Mastene-CHAOUCHE/asservissement-num-rique-d-un-oscillateur-quartz/README.md

# asservissement-num-rique-d-un-oscillateur-quartz
