Mastene-CHAOUCHE/asservissement-num-rique-d-un-oscillateur-quartz/exterior-Case/PCB.FCStd

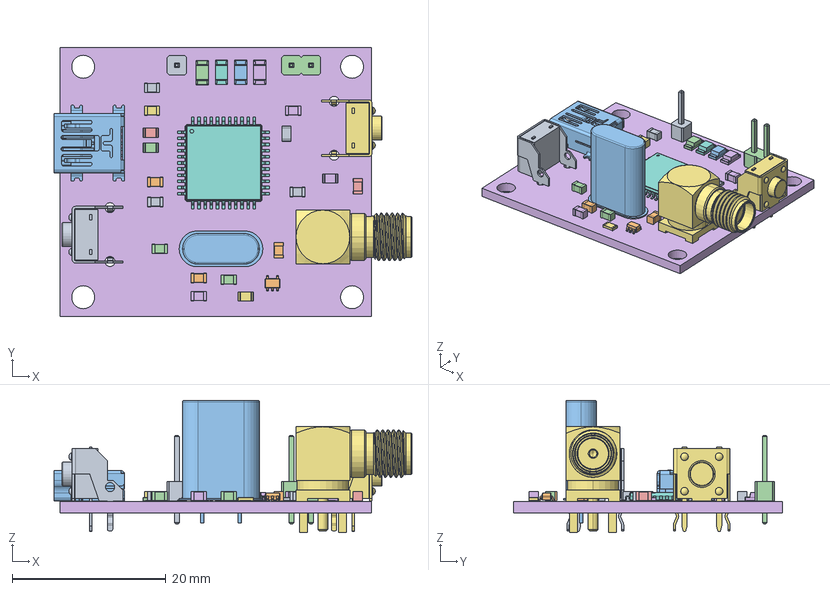
[picture p19: CAD file, 2026-03-27]
exterior-Case/PCB.FCStd
46.6 x 35.0 x 17.2 mm
TQFP-44_10x10mm_P0.8mm001
C_0805_2012Metric012
C_0805_2012Metric013
C_0805_2012Metric014
C_0805_2012Metric015
C_0805_2012Metric016
C_0805_2012Metric017
C_0805_2012Metric018
C_0805_2012Metric019
C_0805_2012Metric020
C_0805_2012Metric021
USB_Mini-B_Lumberg_2486_01_Horizontal001
R_0805_2012Metric005
R_0805_2012Metric006
R_0805_2012Metric007
R_0805_2012Metric008
R_0805_2012Metric009
SW_Tactile_SPST_Angled_PTS645Vx39-2LFS002
SOT-353_SC-70-006
Crystal_HC49-U_Vertical001
PinHeader_1x02_P2.54mm_Vertical001
C_0805_2012Metric022
LED_1206_3216Metric004
SW_Tactile_SPST_Angled_PTS645Vx39-2LFS003
LED_1206_3216Metric005
PinHeader_1x01_P2.54mm_Vertical001
C_0805_2012Metric023
LED_1206_3216Metric006
LED_1206_3216Metric007
atmega_kicad_PCB001
132136_SW0002
TQFP-44_10x10mm_P0.8mm002
C_0805_2012Metric024
C_0805_2012Metric025
C_0805_2012Metric026
C_0805_2012Metric027
C_0805_2012Metric028
C_0805_2012Metric029
C_0805_2012Metric030
C_0805_2012Metric031
C_0805_2012Metric032
C_0805_2012Metric033
USB_Mini-B_Lumberg_2486_01_Horizontal002
R_0805_2012Metric010
R_0805_2012Metric011
R_0805_2012Metric012
R_0805_2012Metric013
R_0805_2012Metric014
SW_Tactile_SPST_Angled_PTS645Vx39-2LFS004
SOT-353_SC-70-007
Crystal_HC49-U_Vertical002
PinHeader_1x02_P2.54mm_Vertical002
C_0805_2012Metric034
LED_1206_3216Metric008
SW_Tactile_SPST_Angled_PTS645Vx39-2LFS005
LED_1206_3216Metric009
PinHeader_1x01_P2.54mm_Vertical002
C_0805_2012Metric035
LED_1206_3216Metric010
LED_1206_3216Metric011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
