Mastene-CHAOUCHE/asservissement-num-rique-d-un-oscillateur-quartz/exterior-Case/Boitier_PCB.FCStd

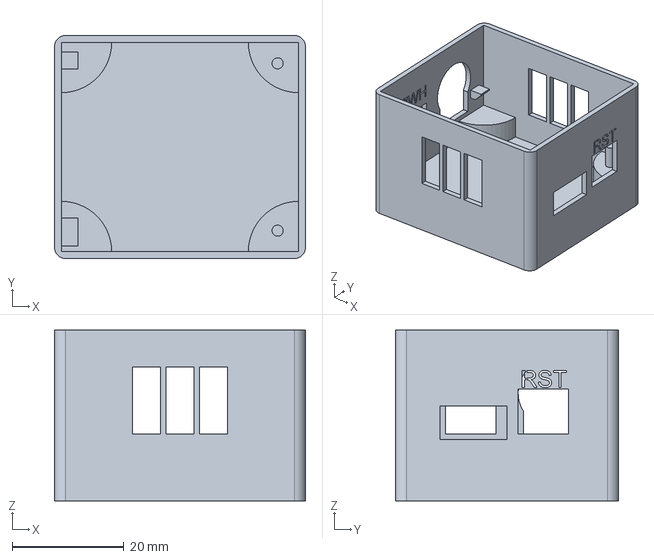
[picture p20: CAD file, 2026-03-27]
exterior-Case/Boitier_PCB.FCStd
45.0 x 40.0 x 30.6 mm
