Mastene-CHAOUCHE/asservissement-num-rique-d-un-oscillateur-quartz/exterior-Case/Couvercle_PCB.FCStd

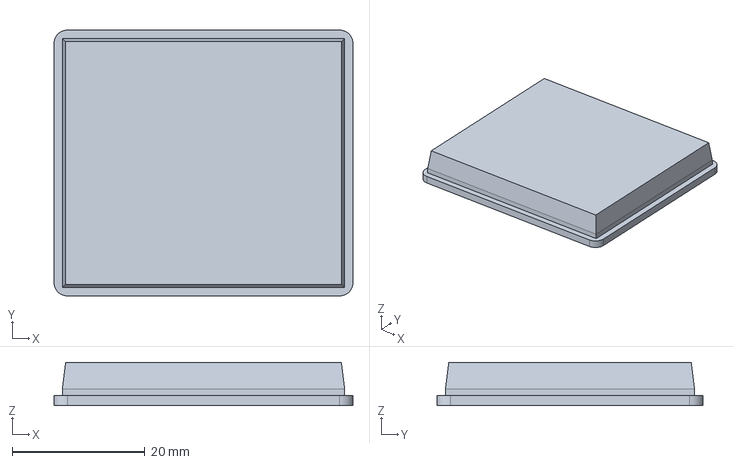
[picture p21: CAD file, 2026-03-27]
exterior-Case/Couvercle_PCB.FCStd
45.0 x 40.0 x 6.50 mm
