Mastene-CHAOUCHE/asservissement-num-rique-d-un-oscillateur-quartz/(list of files, cad)

Other CAD files:
exterior-Case/Assemblage.FCStd
