Mastene-CHAOUCHE/asservissement-num-rique-d-un-oscillateur-quartz/shema et pcb kicad/Projet.kicad_pcb

## KiCad design shema et pcb kicad/Projet.kicad_pcb (2026-03-26)

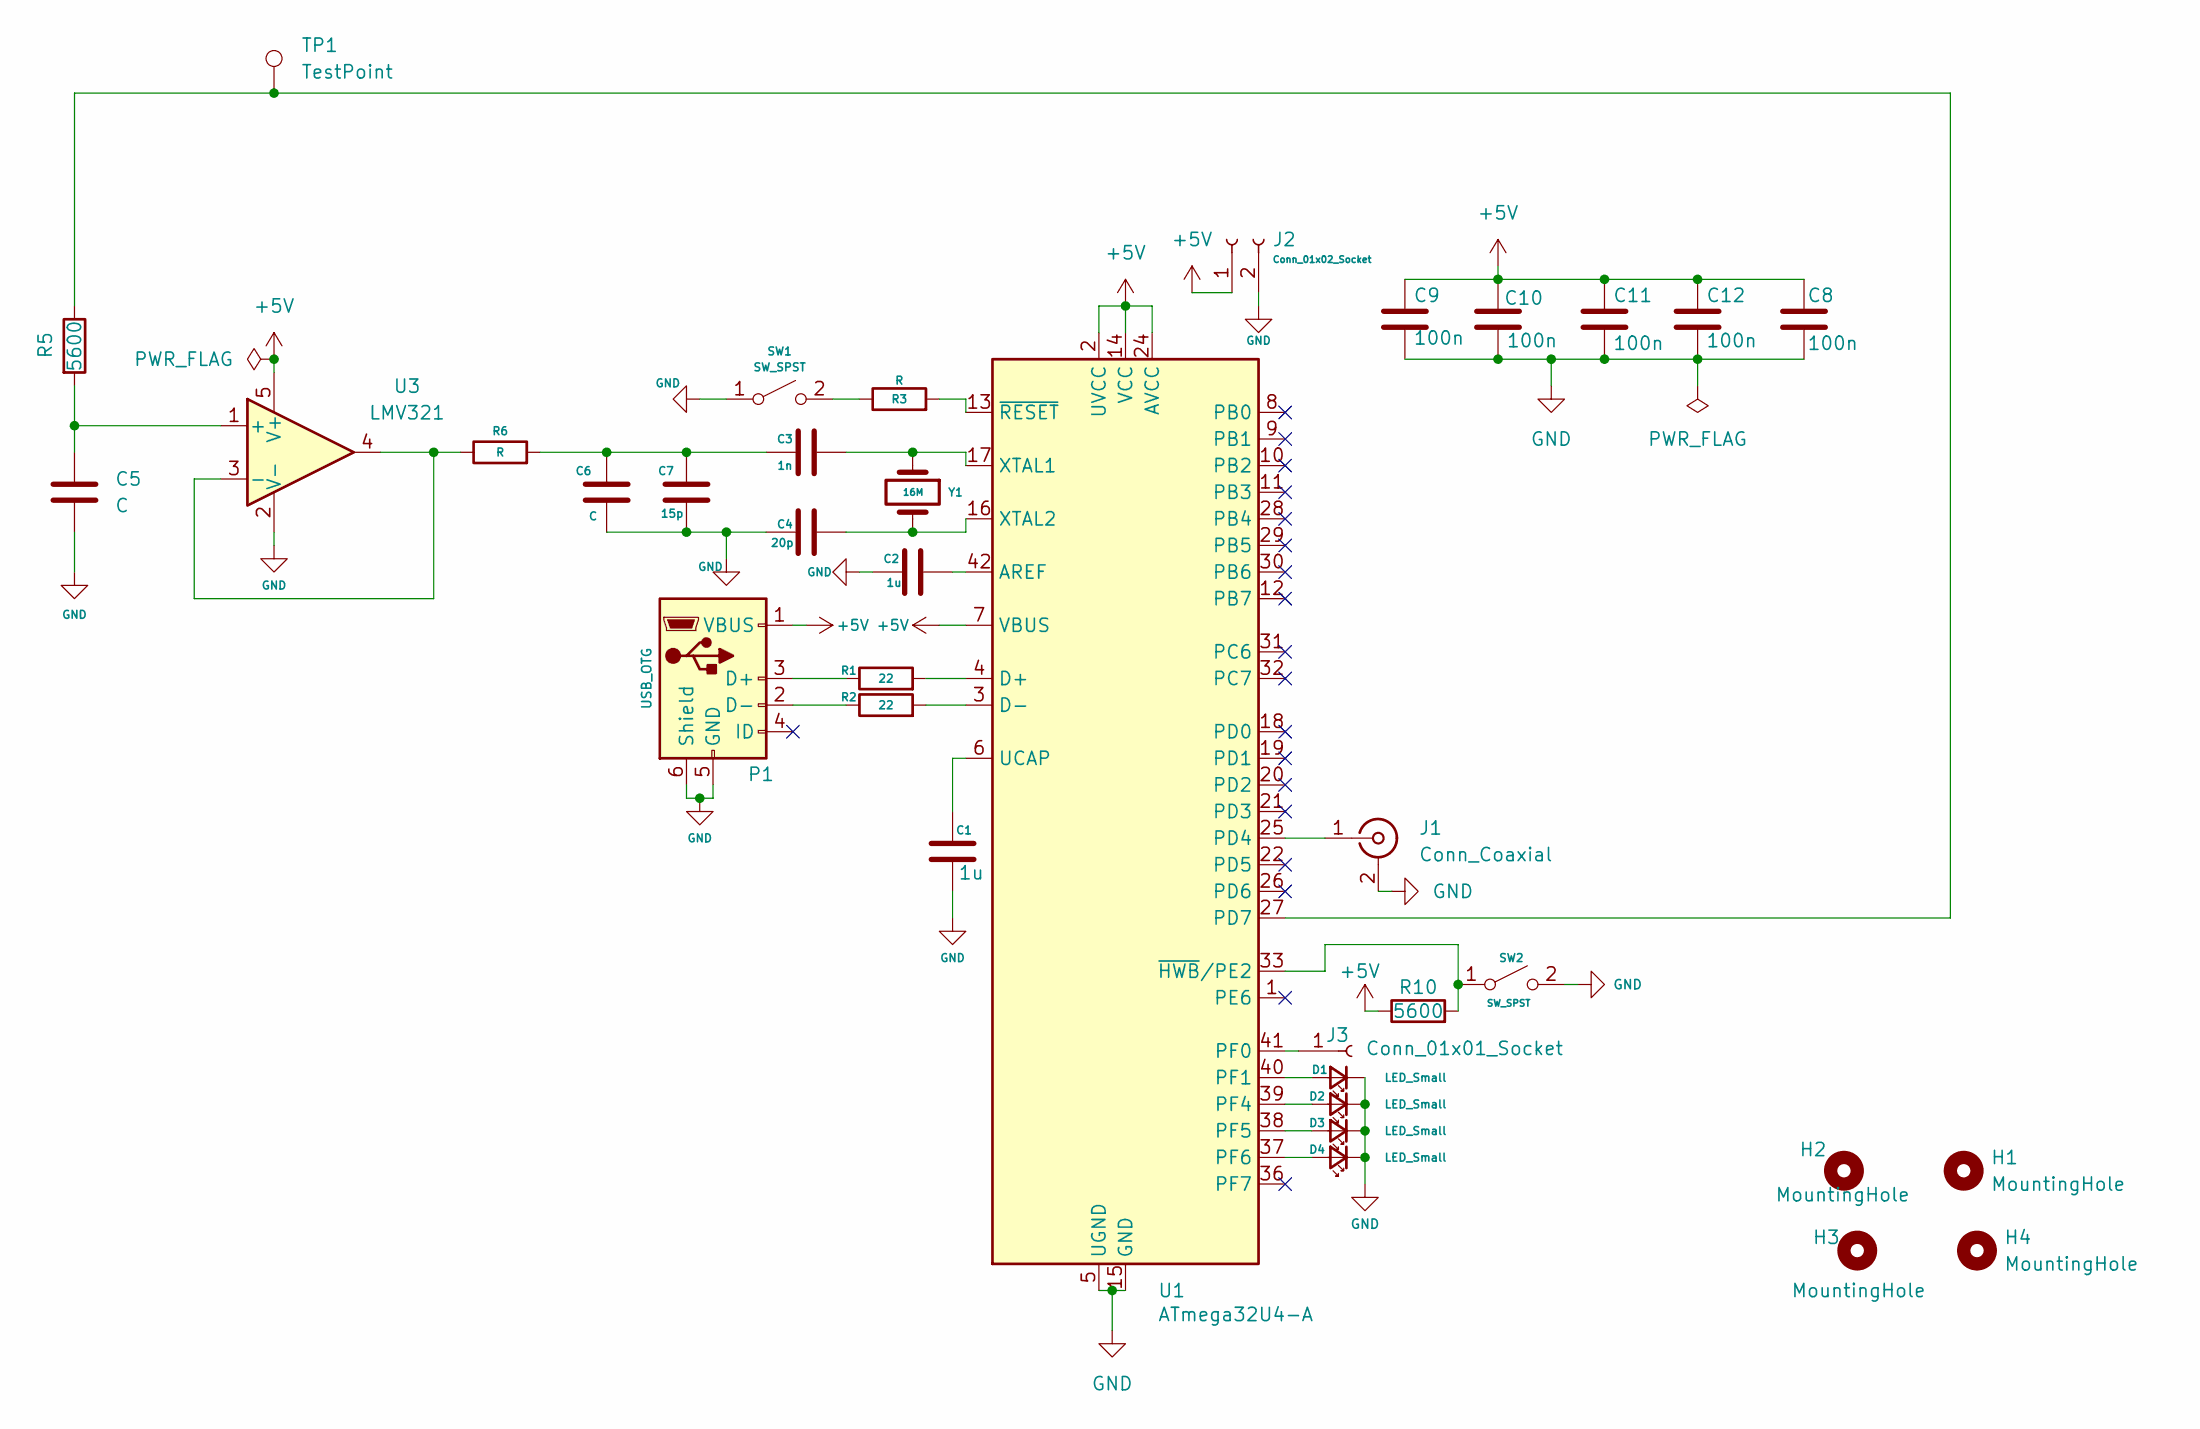
[picture p22: schematic Projet.kicad_sch, asservissement numérique d’un oscillateur à quartz]

Parts:
C1, C2: 1u; C_0805_2012Metric_Pad1.18x1.45mm_HandSolder
C3: 1n; C_0805_2012Metric_Pad1.18x1.45mm_HandSolder
C4: 20p; C_0805_2012Metric_Pad1.18x1.45mm_HandSolder
C5, C6: C; C_0805_2012Metric_Pad1.18x1.45mm_HandSolder
C7: 15p; C_0805_2012Metric_Pad1.18x1.45mm_HandSolder
C8, C9, C10, C11, C12: 100n; C_0805_2012Metric_Pad1.18x1.45mm_HandSolder
D1, D2, D3, D4: LED_Small; LED_1206_3216Metric_Pad1.42x1.75mm_HandSolder
H1, H2, H3, H4: MountingHole; MountingHole_3mm
J1: Conn_Coaxial; SMA_Amphenol_132134_Vertical
J2: Conn_01x02_Socket; PinHeader_1x02_P2.54mm_Vertical
J3: Conn_01x01_Socket; PinHeader_1x01_P2.54mm_Vertical
P1: USB_OTG; USB_Mini-B_Lumberg_2486_01_Horizontal
R1, R2: 22; R_0805_2012Metric_Pad1.20x1.40mm_HandSolder
R3, R6: R; R_0805_2012Metric_Pad1.20x1.40mm_HandSolder
R5, R10: 5600; R_0805_2012Metric_Pad1.20x1.40mm_HandSolder
SW1, SW2: SW_SPST; SW_PUSH_6mm
TP1: TestPoint; TestPoint_Pad_1.0x1.0mm
U1: ATmega32U4-A; TQFP-44_10x10mm_P0.8mm
U3: LMV321; SOT-23-5_HandSoldering
Y1: 16M; Crystal_SMD_5032-2Pin_5.0x3.2mm_HandSoldering

Connections:
+5V: C8.1, C9.1, C10.1, C11.1, C12.1, J2.1, P1.1 (VBUS), R10.1, U1.2 (UVCC), U1.7 (VBUS), U1.14 (VCC), U1.24 (AVCC), U1.34 (VCC), U1.44 (AVCC), U3.5 (V+)
GND: C1.2, C2.1, C4.1, C5.2, C6.2, C7.2, C8.2, C9.2, C10.2, C11.2, C12.2, D1.1 (K), D2.1 (K), D3.1 (K), D4.1 (K), J1.2 (Ext), J2.2, P1.5 (GND), P1.6 (Shield), SW1.1 (A), SW2.2 (B), U1.5 (UGND), U1.15 (GND), U1.23 (GND), U1.35 (GND), U1.43 (GND), U3.2 (V-)
unnamed: C3.2, C6.1, C7.1, R6.2
unnamed: D1.2 (A), U1.40 (PF1)
unnamed: D2.2 (A), U1.39 (PF4)
unnamed: D3.2 (A), U1.38 (PF5)
unnamed: D4.2 (A), U1.37 (PF6)
unnamed: J1.1 (In), U1.25 (PD4)
unnamed: J3.1, U1.41 (PF0)
unnamed: P1.3 (D+), R1.1
unnamed: P1.2 (D-), R2.1
unnamed: R3.1, SW1.2 (B)
unnamed: R10.2, SW2.1 (A), U1.33 (~HWB/PE2)
unnamed: C2.2, U1.42 (AREF)
unnamed: R1.2, U1.4 (D+)
unnamed: R2.2, U1.3 (D-)
unnamed: R5.1, TP1.1, U1.27 (PD7)
unnamed: C1.1, U1.6 (UCAP)
unnamed: C3.1, U1.17 (XTAL1), Y1.1
unnamed: C4.2, U1.16 (XTAL2), Y1.2
unnamed: R3.2, U1.13 (~RESET)
unnamed: C5.1, R5.2, U3.1 (+)
unnamed: R6.1, U3.3 (-), U3.4

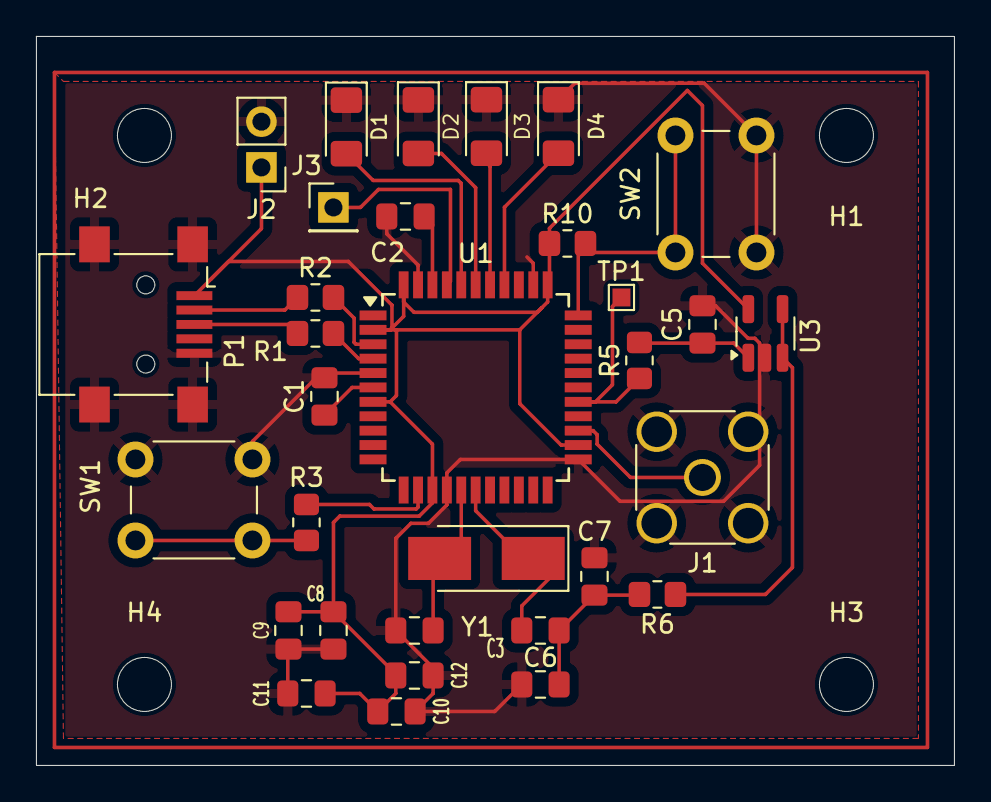
[picture p23: board Projet.kicad_pcb from above]

Board: 2 copper layers, 51.0 x 40.5 mm, 36 parts (0 on the bottom side), 23 nets.
