Mastene-CHAOUCHE/asservissement-num-rique-d-un-oscillateur-quartz/projet_gpsdo_1essai/projet_gpsdo/dfu-programmer/src/config.h

/* src/config.h.  Generated from config.h.in by configure.  */
/* src/config.h.in.  Generated from configure.ac by autoheader.  */

/* Define to 1 if you have the <inttypes.h> header file. */
#define HAVE_INTTYPES_H 1

/* Define to 1 if your system has a GNU libc compatible 'malloc' function, and
   to 0 otherwise. */
#define HAVE_MALLOC 1

/* Define to 1 if you have the <stddef.h> header file. */
#define HAVE_STDDEF_H 1

/* Define to 1 if you have the <stdint.h> header file. */
#define HAVE_STDINT_H 1

/* Define to 1 if you have the <stdio.h> header file. */
#define HAVE_STDIO_H 1

/* Define to 1 if you have the <stdlib.h> header file. */
#define HAVE_STDLIB_H 1

/* Define to 1 if you have the <strings.h> header file. */
#define HAVE_STRINGS_H 1

/* Define to 1 if you have the <string.h> header file. */
#define HAVE_STRING_H 1

/* Define to 1 if you have the <sys/stat.h> header file. */
#define HAVE_SYS_STAT_H 1

/* Define to 1 if you have the <sys/types.h> header file. */
#define HAVE_SYS_TYPES_H 1

/* Define to 1 if you have the <unistd.h> header file. */
#define HAVE_UNISTD_H 1

/* Name of package */
#define PACKAGE "dfu-programmer"

/* Define to the address where bug reports for this package should be sent. */
#define PACKAGE_BUGREPORT "https://github.com/dfu-programmer/dfu-programmer/issues"

/* Define to the full name of this package. */
#define PACKAGE_NAME "dfu-programmer"

/* Define to the full name and version of this package. */
#define PACKAGE_STRING "dfu-programmer 1.1.0"

/* Define to the one symbol short name of this package. */
#define PACKAGE_TARNAME "dfu-programmer"

/* Define to the home page for this package. */
#define PACKAGE_URL "https://dfu-programmer.github.io/"

/* Define to the version of this package. */
#define PACKAGE_VERSION "1.1.0"

/* Define to 1 if all of the C89 standard headers exist (not just the ones
   required in a freestanding environment). This macro is provided for
   backward compatibility; new code need not use it. */
#define STDC_HEADERS 1

/* Version number of package */
#define VERSION "1.1.0"

/* Define to empty if 'const' does not conform to ANSI C. */
/* #undef const */

/* Define to rpl_malloc if the replacement function should be used. */
/* #undef malloc */

/* Define as 'unsigned int' if <stddef.h> doesn't define. */
/* #undef size_t */
