Mastene-CHAOUCHE/asservissement-num-rique-d-un-oscillateur-quartz/(commit log)

2026-03-26 BOM KiCad + liste des composants
    Ajout du BOM KiCad et du PDF des composants (fournisseur : Mouser)
2026-03-26 Ajout du schéma et du PCB KiCad
    [Projet.kicad_pcb, Projet.kicad_sch]
2026-03-26 Shéma et pcd Kicad
    [Projet.kicad_pcb, Projet.kicad_sch]
2026-03-26 Ajout du BOM KiCad et du PDF des composants (fournisseur : Mouser)
